dvh61/AudioPowerSupplyV2.0/Power Supply Board v2.0/Power Supply Board v2.0.jpg

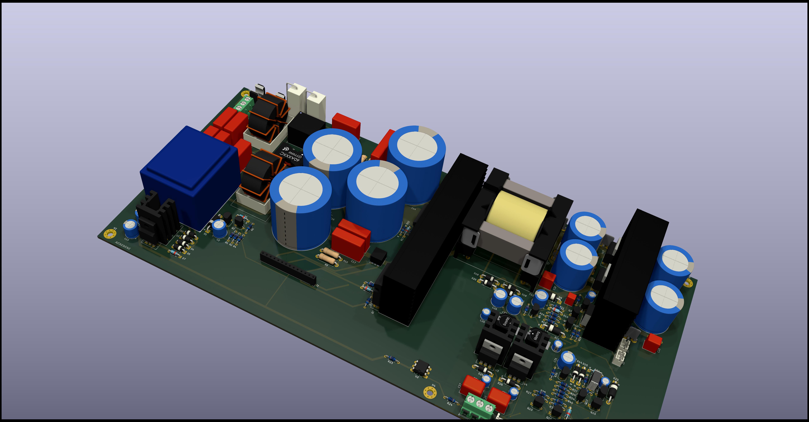
Power Supply Board v2.0/Power Supply Board v2.0.jpg
