dvh61/AudioPowerSupplyV2.0/Power Supply Control Board/Power Supply Control Board/Power Supply Control Board.jpg

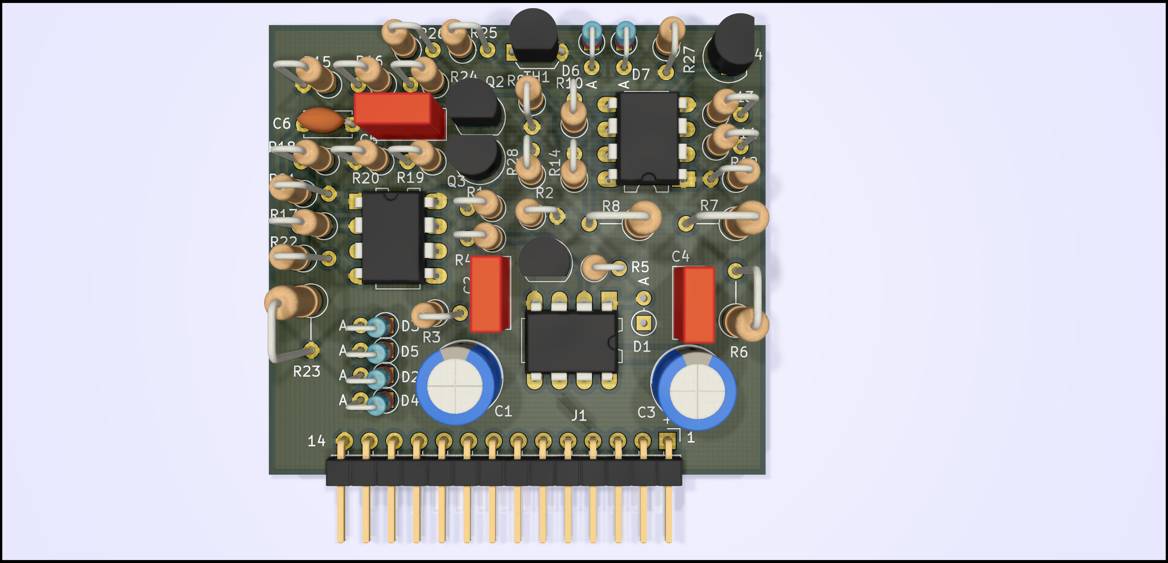
Power Supply Control Board/Power Supply Control Board/Power Supply Control Board.jpg
