dvh61/AudioPowerSupplyV2.0/README.md

# AudioPowerSupplyV2.0
Testing of Kicad/Github capabilities
