dvh61/AudioPowerSupplyV2.0/Power Supply Control Board/Power Supply Control Board/Power Supply Control Board SG3525.jpg

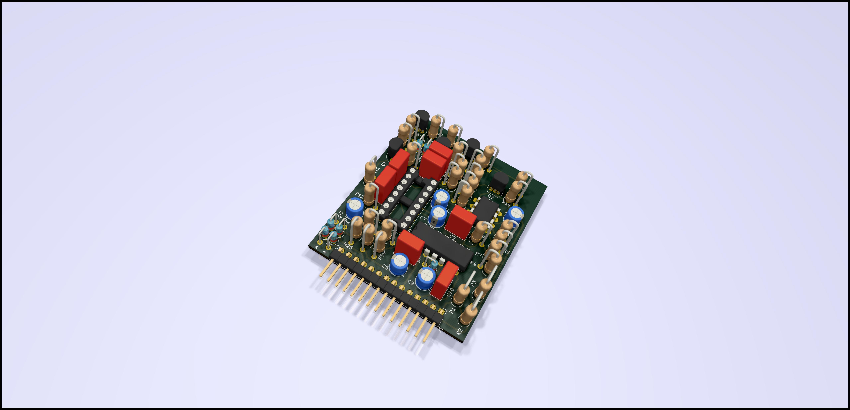
Power Supply Control Board/Power Supply Control Board/Power Supply Control Board SG3525.jpg
