dvh61/AudioPowerSupplyV2.0/Power Supply Control Board/Power Supply Control Board/Gerber/Power Supply Control Board SG3525 BOM.xlsx

Comment | Designator | Footprint | LCSC Part Number
10uF | C1,C4,C5,C7,C8,C13 | 0805 | C15850
100n | C10 | 0805 | C49678
47p | C12 | 0402 | C1567
100uF | C14 | CASE-B_3528 | C16133
0.1uF | C2 | 0805 | C49678
470p | C3 | 0402 | C1537
10n | C6,C9,C11 | 0402 | C15195
US1MG | D1 | SMA | C412437
1N4148 | D2,D3,D4,D5 | SOD-123 | C81598
MMBT5551L | Q1,Q2,Q4 | SOT-23 | C2145
MMBT5401 | Q3 | SOT-23 | C8326
100k | R1,R2,R3 | 1206 | C17900
10k | R11,R18,R19,R20,R21,R22,R27,R28 | 0805 | C17414
22k | R12 | 0805 | C17560
5k6 | R13 | 0805 | C4382
22k | R14 | 0805 | C17560
330 | R15 | 0805 | C17630
470k | R24 | 0805 | C17709
22 | R26 | 1206 | C17958
2k7 | R4 | 0805 | C17530
12k | R17,R23,R25 | 0805 | C17444
47k | R5,R7,R8,R16 | 0805 | C17713
56k | R6 | 0805 | C17756
560 | R9,R10 | 0805 | C28636
LM393 | U1 | SOIC-8_3.9x4.9x1.27P | C7955
SG3525 | U2 | SOIC-16_3.9x9.9x1.27P | C68323
IR2110 | U3 | SOIC-16_7.5x10.3x1.27P | C2968
