dvh61/AudioPowerSupplyV2.0/Power Supply Control Board/Power Supply Control Board/Spice Test Temp KTY.asc

D1: diode; 1N4148
D2: zener; 1N750
Q1: npn; BC546B
Q2: npn; BC546B
R1: res; 18k
R2: res; {Rth}
R3: res; 5k6
R4: res; 12k
R5: res; 33Meg
R6: res; 270k
R7: res; {Rth}
R8: res; 5k6
R10: res; 33Meg
V1: voltage; 16
V2: voltage; 16
Named nets: 0, Out, Out1
.step param T 25 100 1
.meas T
.param factor=table(T,25,1.0,55,0.9,67,1.0,75,1.2,80,1.5,85,2.1,90,3.2,95,9.0,100,30.0)
.meas factor
.param Rth={factor*2200}
;.step param Rth LIST 950 990 1029 1108 1192 1278 1369 1462 1559 1659
.Meas tran res1 FIND V(Out) AT=5m
.op
Thermistor is used PTFM04BD222Q2N34B0.
Data sheet on mouser.de
Circuit for KTY
Circuit for PTFM04BD222Q2N34B0
