dvh61/AudioPowerSupplyV2.0/Auxiliary Power Module/Auxiliary Supply/Auxiliary Supply.kicad_pcb

## KiCad design Auxiliary Power Module/Auxiliary Supply/Auxiliary Supply.kicad_pcb (2021-04-23)

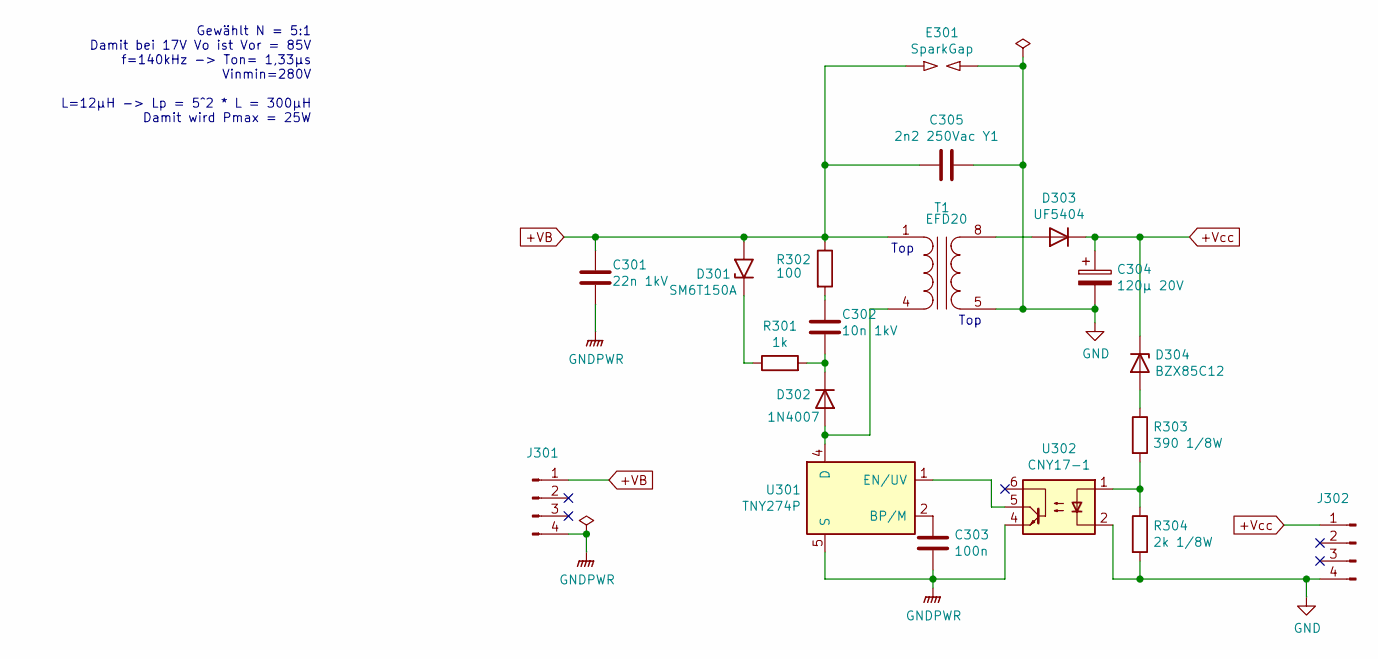
[picture p4: schematic Auxiliary Supply.kicad_sch, Auxiliary Power Supply Board]

Parts:
C301: 22n 1kV; C_Disc_D12.5mm_W5.0mm_P7.50mm
C302: 10n 1kV; C_Disc_D12.5mm_W5.0mm_P7.50mm
C303: 100n; C_Rect_L7.2mm_W2.5mm_P5.00mm_FKS2_FKP2_MKS2_MKP2
C304: 120µ 20V; CP_Radial_D6.3mm_P2.50mm
C305: 2n2 250Vac Y1; C_Rect_L18.0mm_W7.0mm_P15.00mm_FKS3_FKP3
D301: SM6T150A; D_SMB_Handsoldering
D302: 1N4007; D_DO-41_SOD81_P2.54mm_Vertical_KathodeUp
D303: UF5404; D_DO-41_SOD81_P2.54mm_Vertical_KathodeUp
D304: BZX85C12; D_DO-41_SOD81_P3.81mm_Vertical_KathodeUp
E301: SparkGap; SparkGap 5000V Top
J301, J302: Conn_01x04_Male; PinHeader_1x04_P2.54mm_Vertical
R301: 1k; R_Axial_DIN0309_L9.0mm_D3.2mm_P5.08mm_Vertical
R302: 100; R_Axial_DIN0309_L9.0mm_D3.2mm_P12.70mm_Horizontal
R303: 390 1/8W; R_Axial_DIN0207_L6.3mm_D2.5mm_P2.54mm_Vertical
R304: 2k 1/8W; R_Axial_DIN0207_L6.3mm_D2.5mm_P2.54mm_Vertical
T1: B66418W1008D1; Mouser Part Number 871-B66418W1008D1
U301: TNY274P; PowerIntegrations_PDIP-8C
U302: CNY17-1; DIP-6_W7.62mm_LongPads

Connections:
+VB: C301.1, C305.1, D301.2 (A2), E301.1, J301.1, R302.1, T1.1 (AA)
+Vcc: C304.1, D303.1 (K), D304.1 (K), J302.1
GND: C304.2, C305.2, E301.2, J302.4, R304.2, T1.5 (SA), U302.2
GNDPWR: C301.2, C303.2, J301.4, U301.5 (S), U301.6 (S), U301.7 (S), U301.8 (S), U302.4
unnamed: C302.1, R302.2
unnamed: C302.2, D302.1 (K), R301.2
unnamed: C303.1, U301.2 (BP/M)
unnamed: D301.1 (A1), R301.1
unnamed: D302.2 (A), T1.4 (AB), U301.4 (D)
unnamed: D303.2 (A), T1.8 (SB)
unnamed: D304.2 (A), R303.1
unnamed: R303.2, R304.1, U302.1
unnamed: U301.1 (EN/UV), U302.5

Notes on the sheet:
Gewählt N = 5:1 Damit bei 17V Vo ist Vor = 85V f=140kHz -> Ton= 1,33µs Vinmin=280V L=12µH -> Lp = 5^2 * L = 300µH Damit wird Pmax = 25W
Top

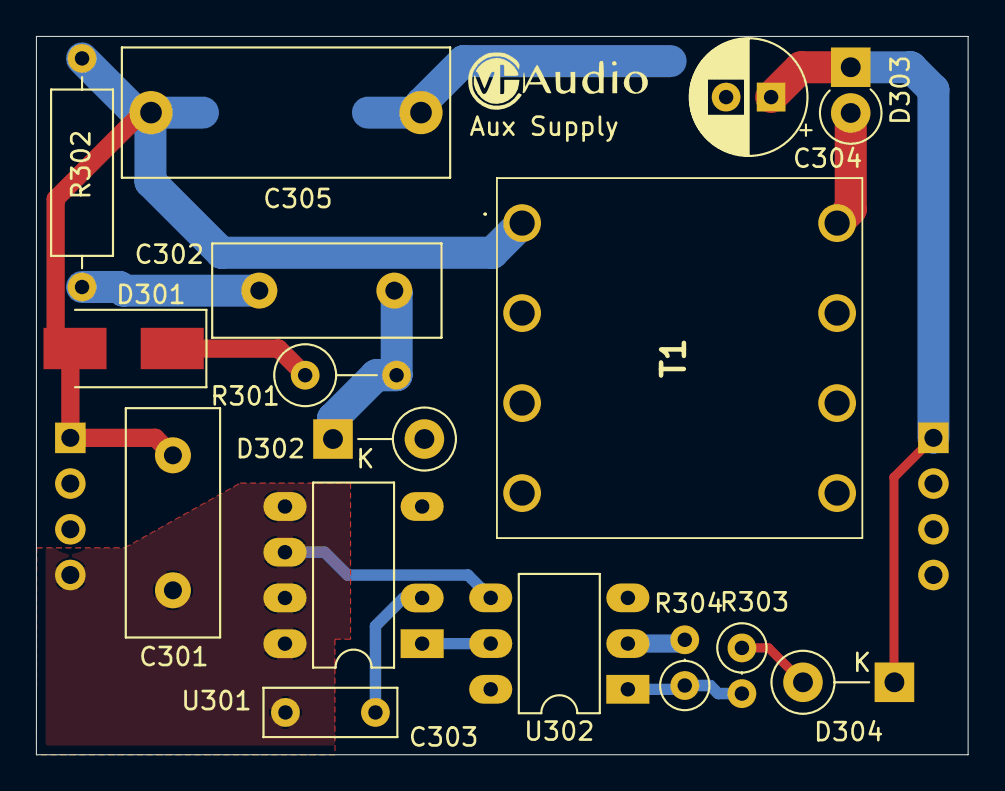
[picture p5: board Auxiliary Supply.kicad_pcb from above]

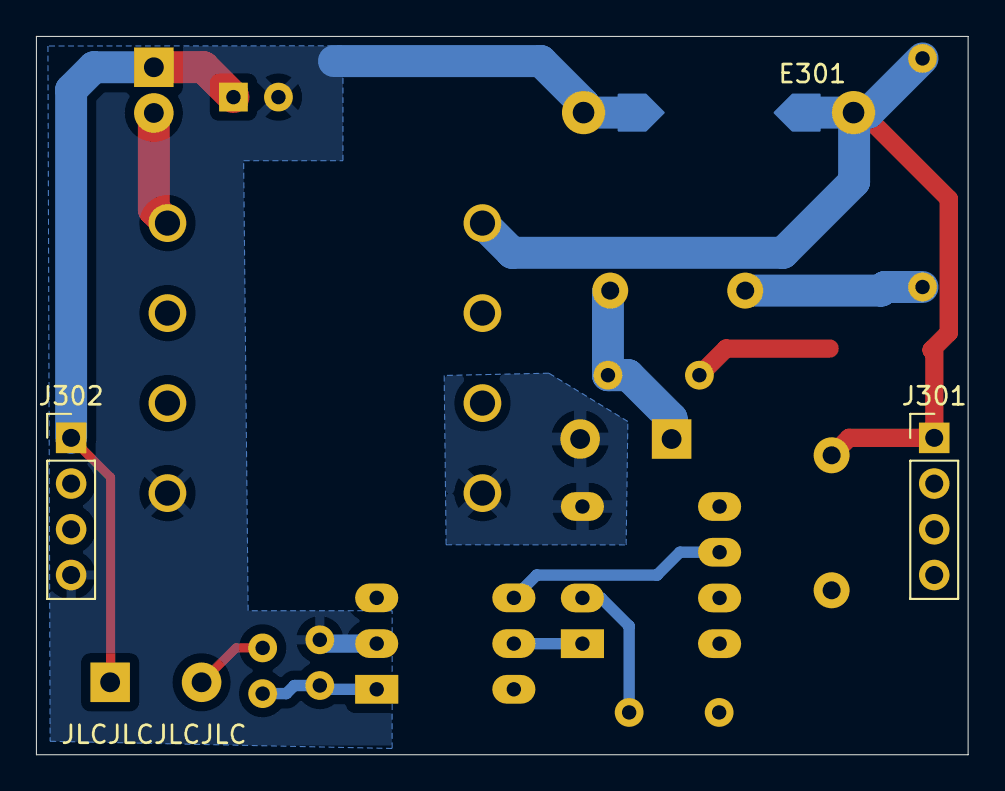
[picture p6: board Auxiliary Supply.kicad_pcb from below]

Board: 2 copper layers, 51.8 x 39.9 mm, 19 parts (3 on the bottom side), 13 nets.
