dvh61/AudioPowerSupplyV2.0/Power Supply Board v2.0/Power Supply Board v2.0.kicad_pcb

## KiCad design Power Supply Board v2.0/Power Supply Board v2.0.kicad_pcb (2021-04-14)

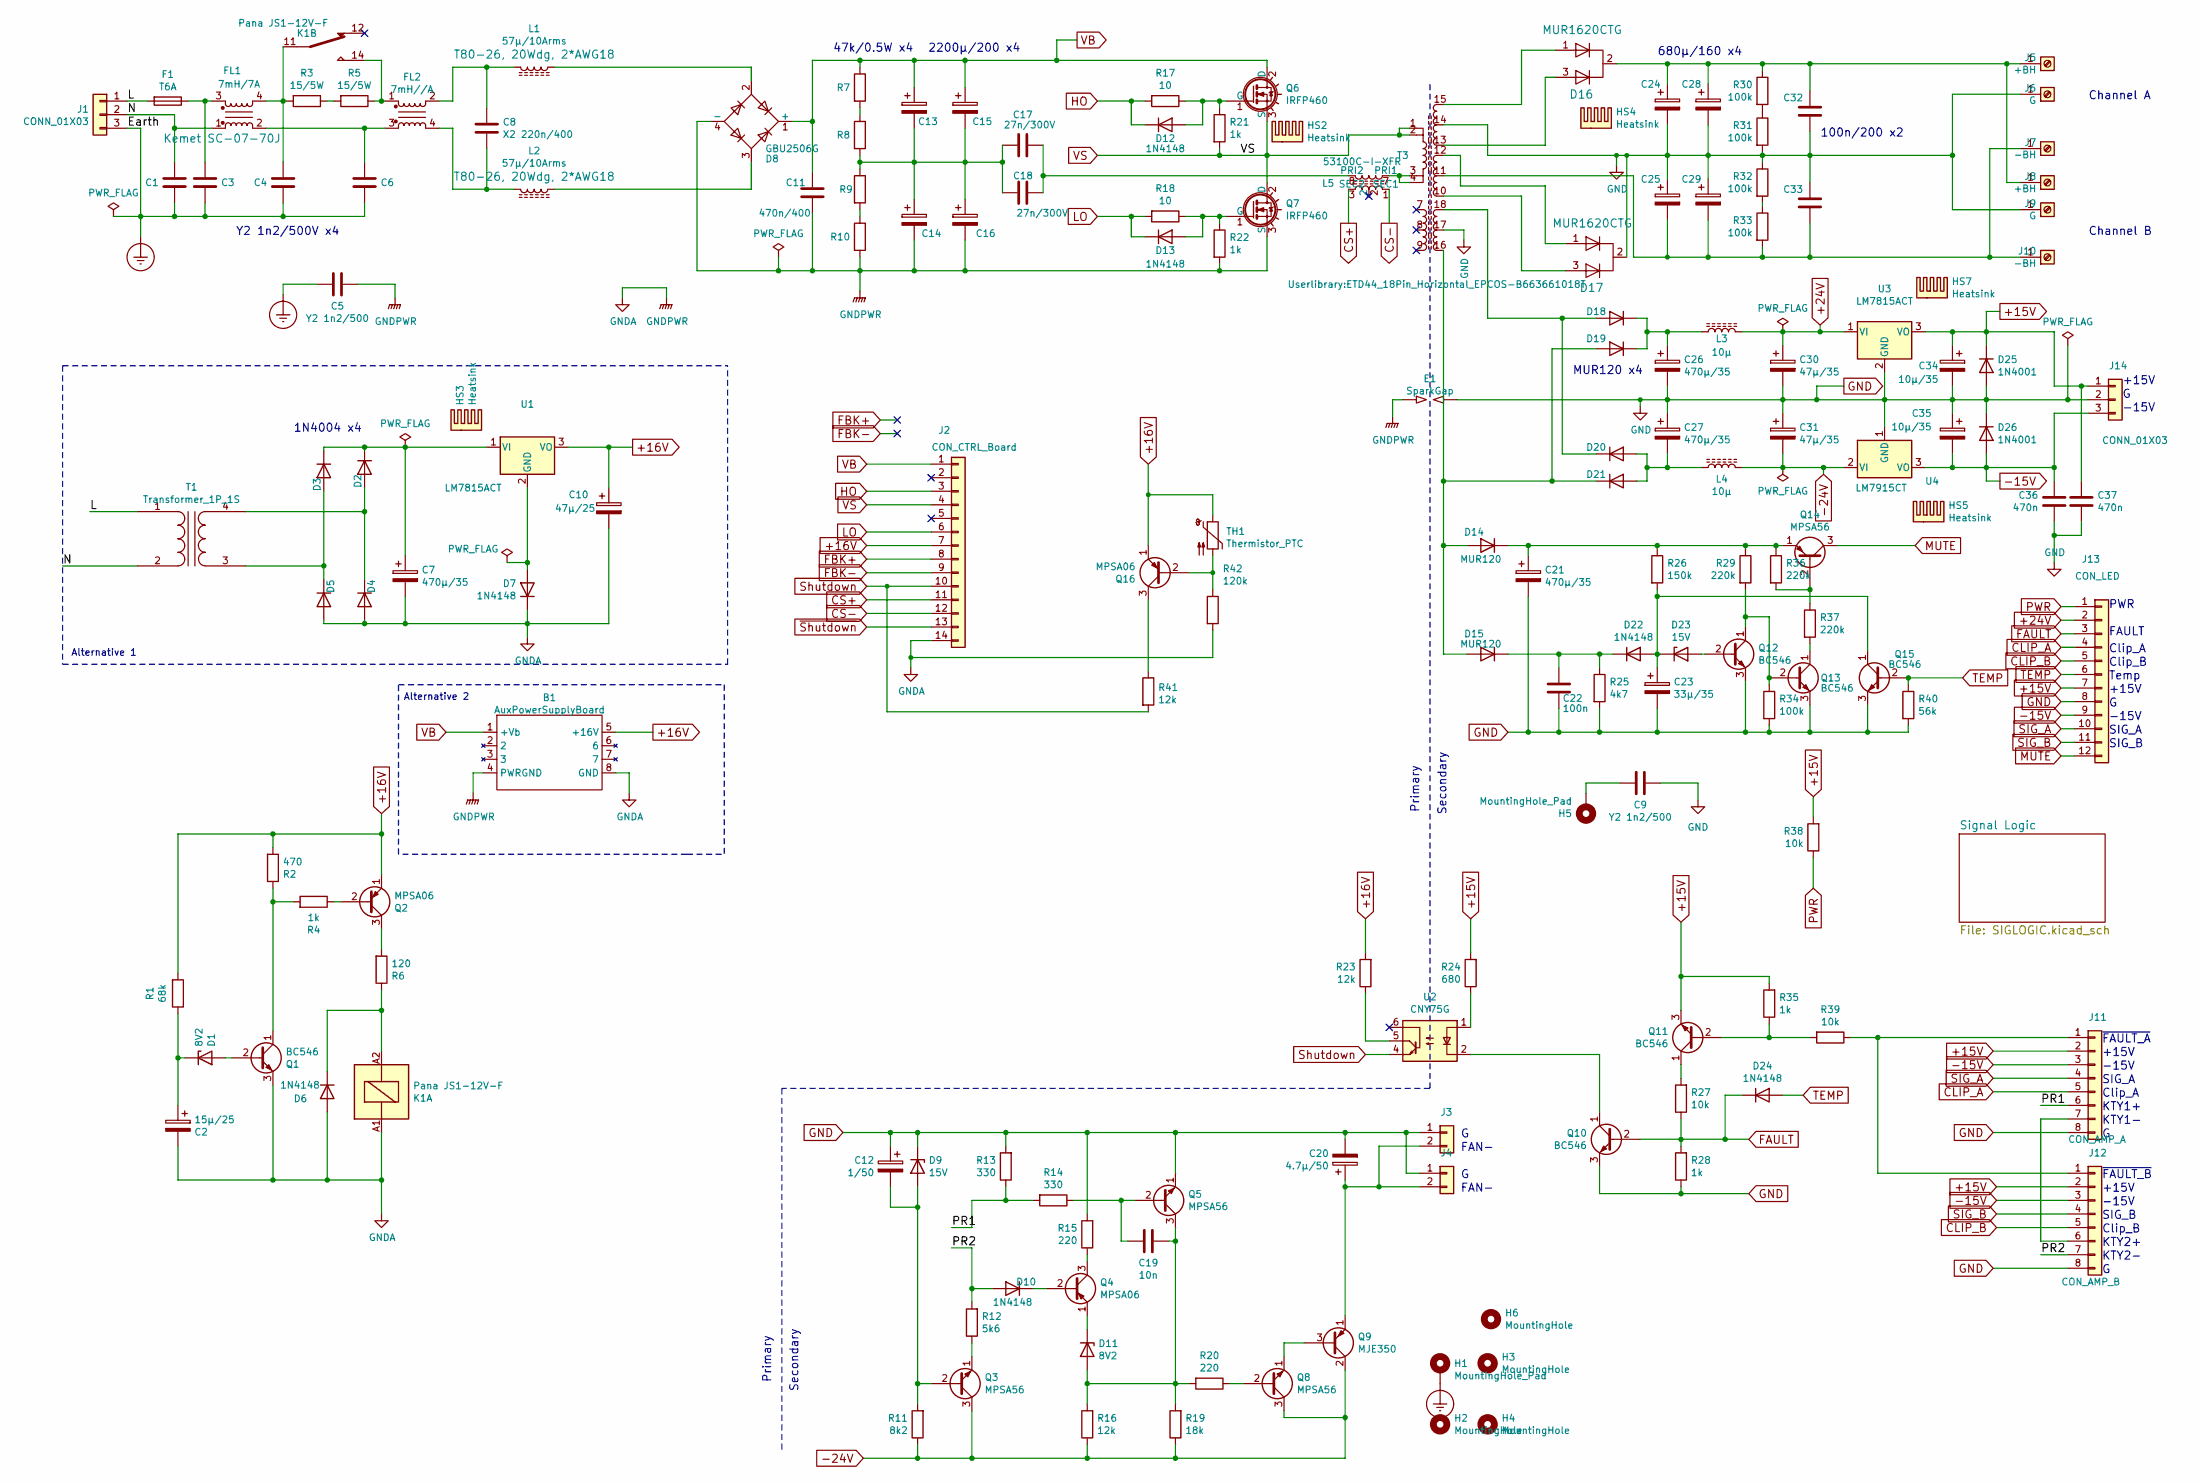
[picture p7: schematic Power Supply Board v2.0.kicad_sch, Power Supply Board]

Parts:
B1: AuxPowerSupplyBoard; Aux Power Supply Board
C1, C3, C4, C5, C6, C9: Y2 1n2/500; C_Rect_L18.0mm_W7.0mm_P15.00mm_FKS3_FKP3
C2: 15µ/25; CP_Radial_D8.0mm_P2.50mm
C7, C21, C26, C27: 470µ/35; CP_Radial_D8.0mm_P3.50mm
C8: X2 220n/400; C_Rect_L18.0mm_W8.0mm_P15.00mm_FKS3_FKP3
C10: 47µ/25; CP_Radial_D8.0mm_P5.00mm
C11: 470n/400; C_Rect_L26.5mm_W6.0mm_P22.50mm_MKS4
C12: 1/50; CP_Radial_D8.0mm_P2.50mm
C13, C14, C15, C16: 2200µ/200V; CP_Radial_D35.0mm_P10.00mm_SnapIn
C17, C18: 27n/300V; C_Rect_L19.0mm_W6.0mm_P15.00mm_MKS4
C19: 10n; C_Rect_L4.6mm_W3.8mm_P2.50mm_MKS02_FKP02
C20: 4.7µ/50; CP_Radial_D5.0mm_P2.00mm
C22: 100n; C_Rect_L9.0mm_W4.0mm_P7.50mm_MKT
C23: 33µ/35; CP_Radial_D5.0mm_P2.00mm
C24, C25, C28, C29: 680µ/200V; CP_Radial_D25.0mm_P10.00mm_SnapIn
C30, C31: 47µ/35; CP_Radial_D5.0mm_P2.50mm
C32, C33: 100n/100; C_Rect_L7.2mm_W5.5mm_P5.00mm_FKS2_FKP2_MKS2_MKP2
C34, C35: 10µ/35; CP_Radial_D5.0mm_P2.50mm
C36, C37: 470n; C_Rect_L7.2mm_W11.0mm_P5.00mm_FKS2_FKP2_MKS2_MKP2
D1, D11: 8V2; D_DO-15_P12.70mm_Horizontal
D2, D3, D4, D5: 1N4004; D_DO-41_SOD81_P7.62mm_Horizontal
D6, D7, D10, D12, D13, D22, D24: 1N4148; D_DO-35_SOD27_P7.62mm_Horizontal
D8: GBU2506G; Diode_Bridge_Vishay_GBU
D9, D23: 15V; D_DO-15_P12.70mm_Horizontal
D14, D15, D18, D19, D20, D21: MUR120; D_DO-41_SOD81_P10.16mm_Horizontal
D16, D17: MUR1620CTG; TO-220-3_Vertical
D25, D26: 1N4001; D_DO-41_SOD81_P10.16mm_Horizontal
E1: SparkGap; SparkGap 5000V Top
F1: T6A; Fuseholder_Cylinder-5x20mm_Schurter_0031_8201_Horizontal_Op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
FL1: 7mH/7A; L_CommonMode_Toroid_Vertical_L35mm_W25mm_Px19mm_Py18mm_Keme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
FL2: 7mH//A; L_CommonMode_Toroid_Vertical_L35mm_W25mm_Px19mm_Py18mm_Keme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
H1, H5: MountingHole_Pad; MountingHole_3.5mm_Pad_Via
H2, H3, H4, H6: MountingHole; MountingHole_3.5mm_Pad_Via
HS2: Heatsink; Heatsink_100x45x18mm_3xFixationM3
HS3, HS5, HS7: Heatsink; Heatsink EA2 T220
HS4: Heatsink; Heatsink_70x45x18mm_2xFixationM3
J1: CONN_01X03; TerminalBlock_Phoenix_PT-1,5-3-5.0-H_1x03_P5.00mm_Horizontal
J2: CON_CTRL_Board; PinSocket_1x14_P2.54mm_Vertical
J3, J4: CONN_01X02; JST_PH_B2B-PH-K_1x02_P2.00mm_Vertical
J5, J8: +BH; PCB_Connector_6.35x0.81mm_Vertical
J6, J9: G; PCB_Connector_6.35x0.81mm_Vertical
J7, J10: -BH; PCB_Connector_6.35x0.81mm_Vertical
J11: CON_AMP_A; JST_EH_B8B-EH-A_1x08_P2.50mm_Vertical
J12: CON_AMP_B; JST_EH_B8B-EH-A_1x08_P2.50mm_Vertical
J13: CON_LED; JST_EH_B12B-EH-A_1x12_P2.50mm_Vertical
J14: CONN_01X03; JST_EH_B3B-EH-A_1x03_P2.50mm_Vertical
K1: Pana JS1-12V-F; FINDER_36.11
L1, L2: 57µ/10Arms; L_muRata_6000A
L3, L4: 10µ; L_Wuerth_WE-PD-Typ-LS_Handsoldering
L5: 53100C-I-XFR; 53100C
Q1, Q10, Q11, Q12, Q13, Q15: BC546; TO-92_Wide
Q2, Q4, Q16: MPSA06; TO-92_Wide
Q3, Q5, Q8: MPSA56; TO-92_Wide
Q6, Q7: IRFP460; TO-247-3_Vertical
Q9: MJE350; TO-126-3_Vertical
Q14: MPSA56; TO-92_Inline
R1: 68k; R_Axial_DIN0204_L3.6mm_D1.6mm_P7.62mm_Horizontal
R2: 470; R_Axial_DIN0204_L3.6mm_D1.6mm_P7.62mm_Horizontal
R3, R5: 15/5W; R_Axial_Power_L25.0mm_W9.0mm_P7.62mm_Vertical
R4, R21, R22, R28, R35: 1k; R_Axial_DIN0204_L3.6mm_D1.6mm_P7.62mm_Horizontal
R6: 120; R_Axial_DIN0204_L3.6mm_D1.6mm_P7.62mm_Horizontal
R7, R8, R9, R10: 47k/0.5W; R_Axial_DIN0411_L9.9mm_D3.6mm_P12.70mm_Horizontal
R11: 8k2; R_Axial_DIN0204_L3.6mm_D1.6mm_P7.62mm_Horizontal
R12: 5k6; R_Axial_DIN0204_L3.6mm_D1.6mm_P7.62mm_Horizontal
R13, R14: 330; R_Axial_DIN0204_L3.6mm_D1.6mm_P7.62mm_Horizontal
R15, R20: 220; R_Axial_DIN0204_L3.6mm_D1.6mm_P7.62mm_Horizontal
R16, R23, R41: 12k; R_Axial_DIN0204_L3.6mm_D1.6mm_P7.62mm_Horizontal
R17, R18: 10; R_Axial_DIN0204_L3.6mm_D1.6mm_P7.62mm_Horizontal
R19: 18k; R_Axial_DIN0204_L3.6mm_D1.6mm_P7.62mm_Horizontal
R24: 680; R_Axial_DIN0204_L3.6mm_D1.6mm_P7.62mm_Horizontal
R25: 4k7; R_Axial_DIN0204_L3.6mm_D1.6mm_P7.62mm_Horizontal
R26: 150k; R_Axial_DIN0204_L3.6mm_D1.6mm_P7.62mm_Horizontal
R27, R38, R39: 10k; R_Axial_DIN0204_L3.6mm_D1.6mm_P7.62mm_Horizontal
R29, R36, R37: 220k; R_Axial_DIN0204_L3.6mm_D1.6mm_P7.62mm_Horizontal
R30, R31, R32, R33, R34: 100k; R_Axial_DIN0204_L3.6mm_D1.6mm_P7.62mm_Horizontal
R40: 56k; R_Axial_DIN0204_L3.6mm_D1.6mm_P7.62mm_Horizontal
R42: 120k; R_Axial_DIN0204_L3.6mm_D1.6mm_P7.62mm_Horizontal
T1: Transformer_1P_1S; Transformer_Block_EI42_VC-05VA_1xSec
T3: Half_Bridge_Transformer; ETD44_18Pin_Horizontal_EPCOS-B663661018T
TH1: Thermistor_PTC; PTC Epcos D1052
U1: LM7815ACT; TO-220F-3_Vertical
U2: CNY75G; DIP-6_W7.62mm_LongPads
U3: LM7815ACT; TO-220-3_Vertical
U4: LM7915CT; TO-220-3_Vertical

Connections:
+15V: C34.1, C37.1, D25.1 (K), J11.2, J12.2, J13.7, J14.1, Q11.3 (E), R24.2, R35.2, R38.2, U3.3 (VO)
+16V: B1.5 (+16V), C10.1, J2.7, Q2.1 (E), Q16.1 (E), R1.2, R2.2, R23.2, TH1.1, U1.3 (VO)
+24V: C30.1, J13.2, L3.1, U3.1 (VI)
-15V: C35.2, C36.1, D26.2 (A), J11.3, J12.3, J13.9, J14.3, U4.3 (VO)
-24V: C31.2, L4.1, Q3.3 (C), Q8.3 (C), Q9.2 (C), R11.1, R16.1, R19.1, U4.2 (VI)
/L: F1.2, J1.1, T1.1 (AA)
/N: C1.1, FL1.1, J1.2, T1.2 (AB)
/PR1: J11.6, R13.1, R14.2
/PR2: D10.2 (A), J12.7, R12.2
CLIP_A: J11.5, J13.4
CLIP_B: J12.5, J13.5
CS+: J2.11, L5.3 (SEC2)
CS-: J2.12, L5.1 (SEC1)
Earth_Protective: C1.2, C3.2, C4.2, C5.2, C6.2, H1.1, J1.3
FAULT: D24.1 (K), J13.3, Q10.2 (B), R27.1, R28.2
FBK+: J2.8
FBK-: J2.9
GND: C9.1, C12.1, C20.2, C21.2, C22.2, C23.2, C24.2, C25.1, C26.2, C27.1, C28.2, C29.1, C30.2, C31.1, C32.2, C33.1, C34.2, C35.1, C36.2, C37.2, D9.1 (K), D17.2 (common), D25.2 (A), D26.1 (K), E1.2, J3.1, J4.1, J6.1, J9.1, J11.8, J12.8, J13.8, J14.2, Q5.1 (E), Q10.3 (E), Q12.3 (E), Q13.3 (E), Q15.3 (E), R13.2, R15.2, R25.2, R28.1, R31.2, R32.1, R34.2, R40.2, T3.14, T3.17, U3.2 (GND), U4.1 (GND)
GNDA: B1.4 (PWRGND), B1.8 (GND), C2.2, C5.1, C7.2, C10.2, C11.1, C14.2, C16.2, D4.2 (A), D5.2 (A), D6.2 (A), D7.1 (K), D8.4 (-), E1.1, J2.14, K1.A1, Q1.3 (E), Q7.3 (S), R10.2, R22.2, R42.2
HO: D12.1 (K), J2.3, R17.2
LO: D13.1 (K), J2.6, R18.2
MUTE: J13.12, Q14.3 (C)
unnamed: C2.1, D1.1 (K), R1.1
unnamed: C3.1, F1.1, FL1.3
unnamed: C4.1, FL1.4, K1.11, R3.2
unnamed: C6.1, FL1.2, FL2.3
unnamed: C7.1, D2.1 (K), D3.1 (K), U1.1 (VI)
unnamed: C8.1, FL2.2, L1.2
unnamed: C8.2, FL2.4, L2.2
unnamed: C9.2, H5.1
unnamed: C12.2, D9.2 (A), Q3.2 (B), R11.2
unnamed: C13.2, C14.1, C15.2, C16.1, C17.2, C18.1, R8.2, R9.1
unnamed: C17.1, C18.2, L5.8 (PRI2)
unnamed: C19.1, Q5.2 (B), R14.1
unnamed: C19.2, D11.2 (A), Q5.3 (C), R16.2, R19.2, R20.2
unnamed: C20.1, J3.2, J4.2, Q9.1 (E)
unnamed: C21.1, D14.1 (K), Q14.1 (E), R26.1, R29.1, R36.1
unnamed: C22.1, D15.1 (K), D22.1 (K), R25.1
unnamed: C23.1, D22.2 (A), D23.1 (K), Q15.1 (C), R26.2
unnamed: C24.1, C28.1, C32.1, D16.2 (common), J5.1, J8.1, R30.1
unnamed: C25.2, C29.2, C33.2, J7.1, J10.1, R33.2, T3.11
unnamed: C26.1, D18.1 (K), D19.1 (K), L3.2
unnamed: C27.2, D20.2 (A), D21.2 (A), L4.2
unnamed: D1.2 (A), Q1.2 (B)
unnamed: D2.2 (A), D4.1 (K), T1.4 (SB)
unnamed: D3.2 (A), D5.1 (K), T1.3 (SA)
unnamed: D6.1 (K), K1.A2, R6.1
unnamed: D7.2 (A), U1.2 (GND)
unnamed: D8.2 (~~), L1.1
unnamed: D8.3 (~~), L2.1
unnamed: D10.1 (K), Q4.2 (B)
unnamed: D11.1 (K), Q4.1 (E)
unnamed: D12.2 (A), Q6.1 (G), R17.1, R21.1
unnamed: D13.2 (A), Q7.1 (G), R18.1, R22.1
unnamed: D14.2 (A), D15.2 (A), D19.2 (A), D21.1 (K), T3.16
unnamed: D16.1 (A1), T3.15
unnamed: D16.3 (A2), T3.13
unnamed: D18.2 (A), D20.1 (K), T3.18
unnamed: D23.2 (A), Q12.2 (B)
unnamed: FL2.1, K1.14, R5.1
unnamed: J11.1, J12.1, R39.1
unnamed: J11.7, J12.6
unnamed: L5.7 (PRI1), T3.3, T3.4
unnamed: Q1.1 (C), R2.1, R4.2
unnamed: Q2.2 (B), R4.1
unnamed: Q2.3 (C), R6.2
unnamed: Q3.1 (E), R12.1
unnamed: Q4.3 (C), R15.1
unnamed: Q8.1 (E), Q9.3 (B)
unnamed: Q8.2 (B), R20.1
unnamed: Q10.1 (C), U2.2
unnamed: Q11.1 (C), R27.2
unnamed: Q11.2 (B), R35.1, R39.2
unnamed: Q12.1 (C), Q13.2 (B), R29.2, R34.1
unnamed: Q13.1 (C), R37.2
unnamed: Q14.2 (B), R36.2, R37.1
unnamed: Q16.2 (B), R42.1, TH1.2
unnamed: Q16.3 (C), R41.1
unnamed: R3.1, R5.2
unnamed: R7.2, R8.1
unnamed: R9.2, R10.1
unnamed: R23.1, U2.5
unnamed: R24.1, U2.1
unnamed: R30.2, R31.1
unnamed: R32.2, R33.1
unnamed: D17.3 (A2), T3.10
unnamed: D17.1 (A1), T3.12
PWR: J13.1, R38.1
SIG_A: J11.4, J13.10
SIG_B: J12.4, J13.11
Shutdown: J2.10, R41.2, U2.4
TEMP: D24.2 (A), J13.6, Q15.2 (B), R40.1
VB: B1.1 (+Vb), C11.2, C13.1, C15.1, D8.1 (+), J2.1, Q6.2 (D), R7.1
VS: J2.4, Q6.3 (S), Q7.2 (D), R21.2, T3.1, T3.2
~Shutdown: J2.13

Notes on the sheet:
Alternative 1
Y2 1n2/500V x4
1N4004 x4
Alternative 2
Primary
Secondary
47k/0.5W x4
2200µ/200 x4
FAN-
MUR120 x4
680µ/160 x4
100n/200 x2
Channel A
Channel B
~FAULT_A
+15V
-15V
SIG_A
Clip_A
KTY1+
KTY1-
~FAULT_B
SIG_B
Clip_B
KTY2+
KTY2-
PWR
FAULT
Temp
SIG_B

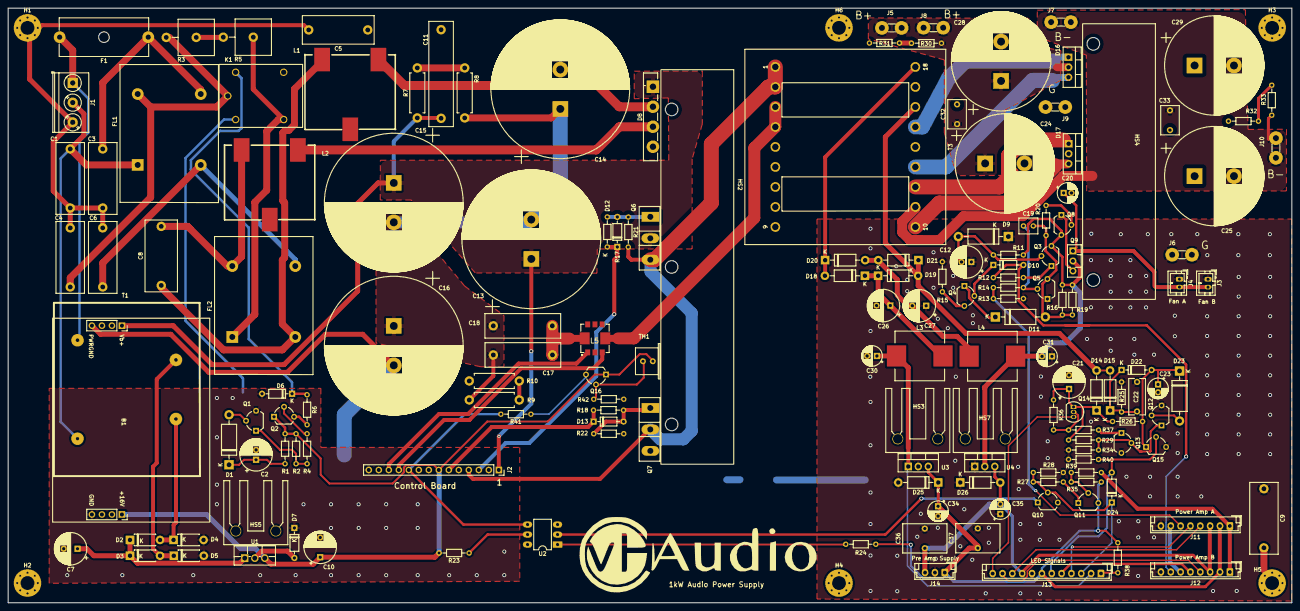
[picture p8: board Power Supply Board v2.0.kicad_pcb from above]

Board: 2 copper layers, 326.0 x 151.0 mm, 164 parts (1 on the bottom side), 92 nets.
