dvh61/AudioPowerSupplyV2.0/Power Supply Control Board/Power Supply Control Board/Power Supply Control Board.kicad_pcb

## KiCad design Power Supply Control Board/Power Supply Control Board/Power Supply Control Board.kicad_pcb (2021-04-09)

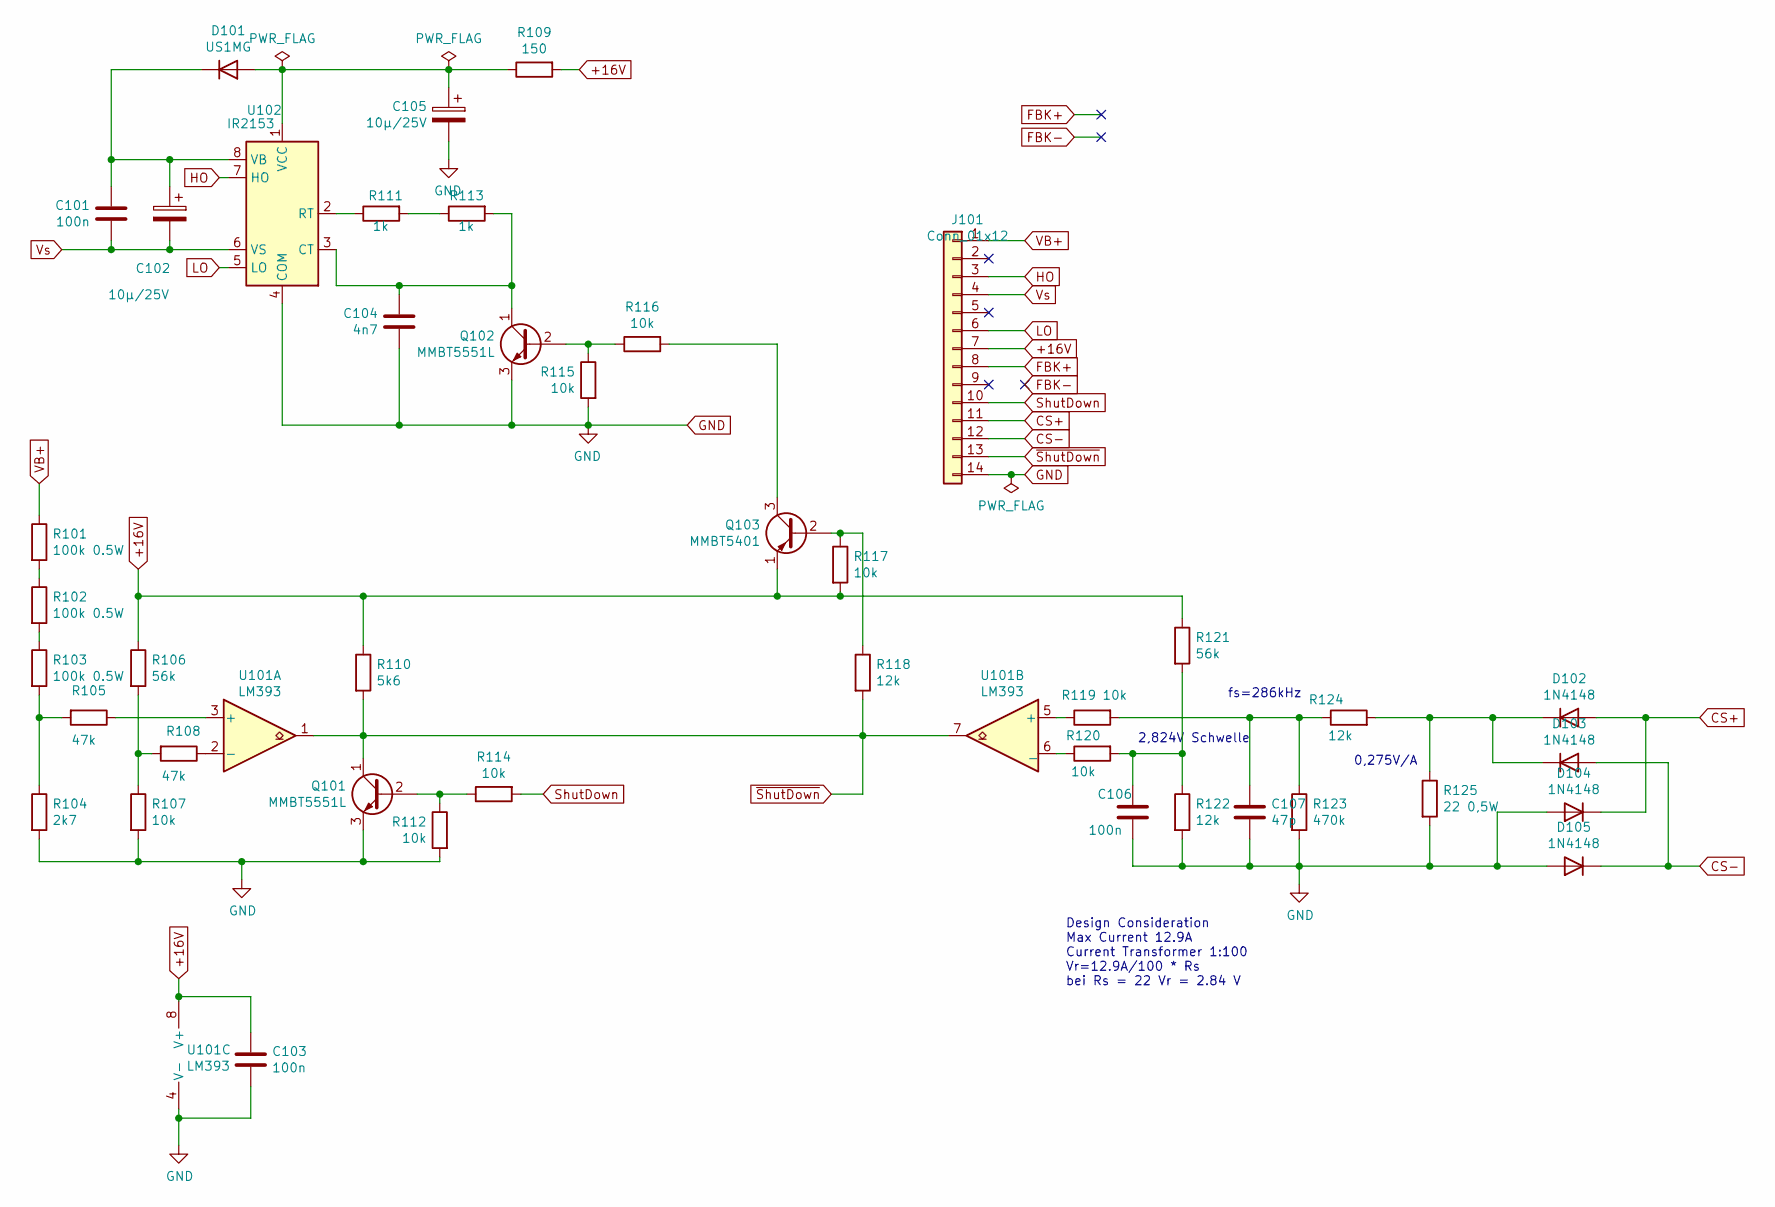
[picture p9: schematic Power Supply Control Board.kicad_sch, Power Supply Control Board IR2153]

Parts:
C101, C103, C106: 100n; C_0805_2012Metric
C102, C105: 10µ/25V; C_0805_2012Metric
C104: 4n7; C_0805_2012Metric
C107: 47p; C_0402_1005Metric
D101: US1MG; D_SMA
D102, D103, D104, D105: 1N4148; D_SOD-123
J101: Conn_01x12; PinHeader_1x14_P2.54mm_Horizontal
Q101, Q102: MMBT5551L; SOT-23
Q103: MMBT5401; SOT-23
R101, R102, R103: 100k 0.5W; R_1206_3216Metric
R104: 2k7; R_0805_2012Metric
R105, R108: 47k; R_0805_2012Metric
R106, R121: 56k; R_0805_2012Metric
R107, R112, R114, R115, R116, R117, R119, R120: 10k; R_0805_2012Metric
R109: 150; R_0805_2012Metric
R110: 5k6; R_0805_2012Metric
R111, R113: 1k; R_0805_2012Metric
R118, R122, R124: 12k; R_0805_2012Metric
R123: 470k; R_0805_2012Metric
R125: 22 0,5W; R_1206_3216Metric
U101: LM393; SOIC-8_3.9x4.9mm_P1.27mm
U102: IR2153; SOIC-8_3.9x4.9mm_P1.27mm; LCSC C79666

Connections:
+16V: C103.1, J101.7, Q103.1 (E), R106.1, R109.2, R110.1, R117.2, R121.1, U101.8 (V+)
CS+: D102.2 (A), D104.1 (K), J101.11
CS-: D103.2 (A), D105.1 (K), J101.12
FBK+: J101.8
GND: C103.2, C104.2, C105.2, C106.2, C107.2, D104.2 (A), D105.2 (A), J101.14, Q101.3 (E), Q102.3 (E), R104.2, R107.2, R112.2, R115.2, R122.2, R123.2, R125.2, U101.4 (V-), U102.4 (COM)
HO: J101.3, U102.7 (HO)
LO: J101.6, U102.5 (LO)
unnamed: C101.1, C102.1, D101.1 (K), U102.8 (VB)
unnamed: C104.1, Q102.1 (C), R113.2, U102.3 (CT)
unnamed: C106.1, R120.2, R121.2, R122.1
unnamed: C107.1, R119.2, R123.1, R124.1
unnamed: C105.1, D101.2 (A), R109.1, U102.1 (VCC)
unnamed: D102.1 (K), D103.1 (K), R124.2, R125.1
unnamed: Q101.2 (B), R112.1, R114.1
unnamed: Q102.2 (B), R115.1, R116.1
unnamed: Q103.2 (B), R117.1, R118.1
unnamed: Q103.3 (C), R116.2
unnamed: R101.2, R102.1
unnamed: R102.2, R103.1
unnamed: R103.2, R104.1, R105.2
unnamed: R105.1, U101.3 (+)
unnamed: R106.2, R107.1, R108.2
unnamed: R108.1, U101.2 (-)
unnamed: R111.1, U102.2 (RT)
unnamed: R111.2, R113.1
unnamed: R119.1, U101.5 (+)
unnamed: R120.1, U101.6 (_)
ShutDown: J101.10, R114.2
VB+: J101.1, R101.1
Vs: C101.2, C102.2, J101.4, U102.6 (VS)
~ShutDown: J101.13, Q101.1 (C), R110.2, R118.2, U101.1, U101.7

Notes on the sheet:
Design Consideration Max Current 12.9A Current Transformer 1:100 Vr=12.9A/100 * Rs bei Rs = 22 Vr = 2.84 V
2,824V Schwelle
fs=286kHz
0,275V/A

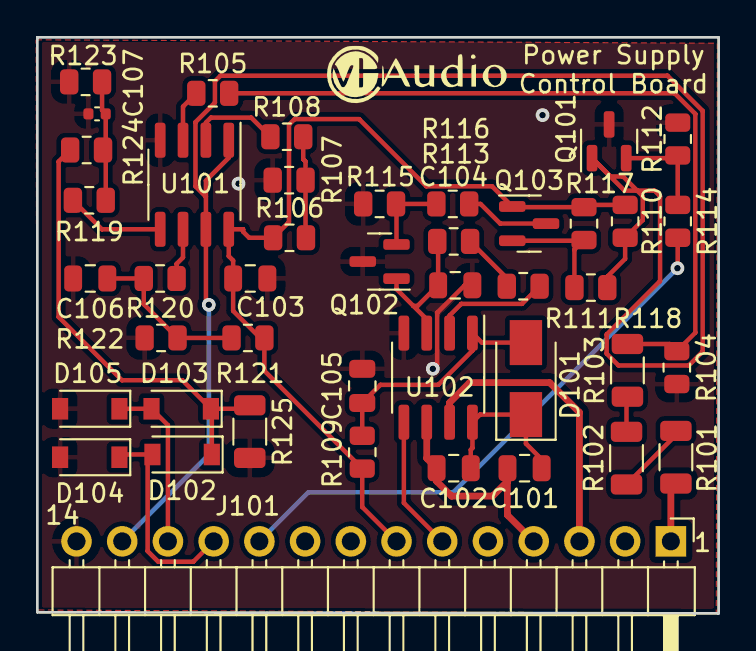
[picture p10: board Power Supply Control Board.kicad_pcb from above]

Board: 2 copper layers, 37.8 x 32.0 mm, 43 parts (0 on the bottom side), 30 nets.
