dvh61/AudioPowerSupplyV2.0/Power Supply Control Board/Power Supply Control Board/Power Supply Control Board SG3525.kicad_pcb

## KiCad design Power Supply Control Board/Power Supply Control Board/Power Supply Control Board SG3525.kicad_pcb (2021-04-09)

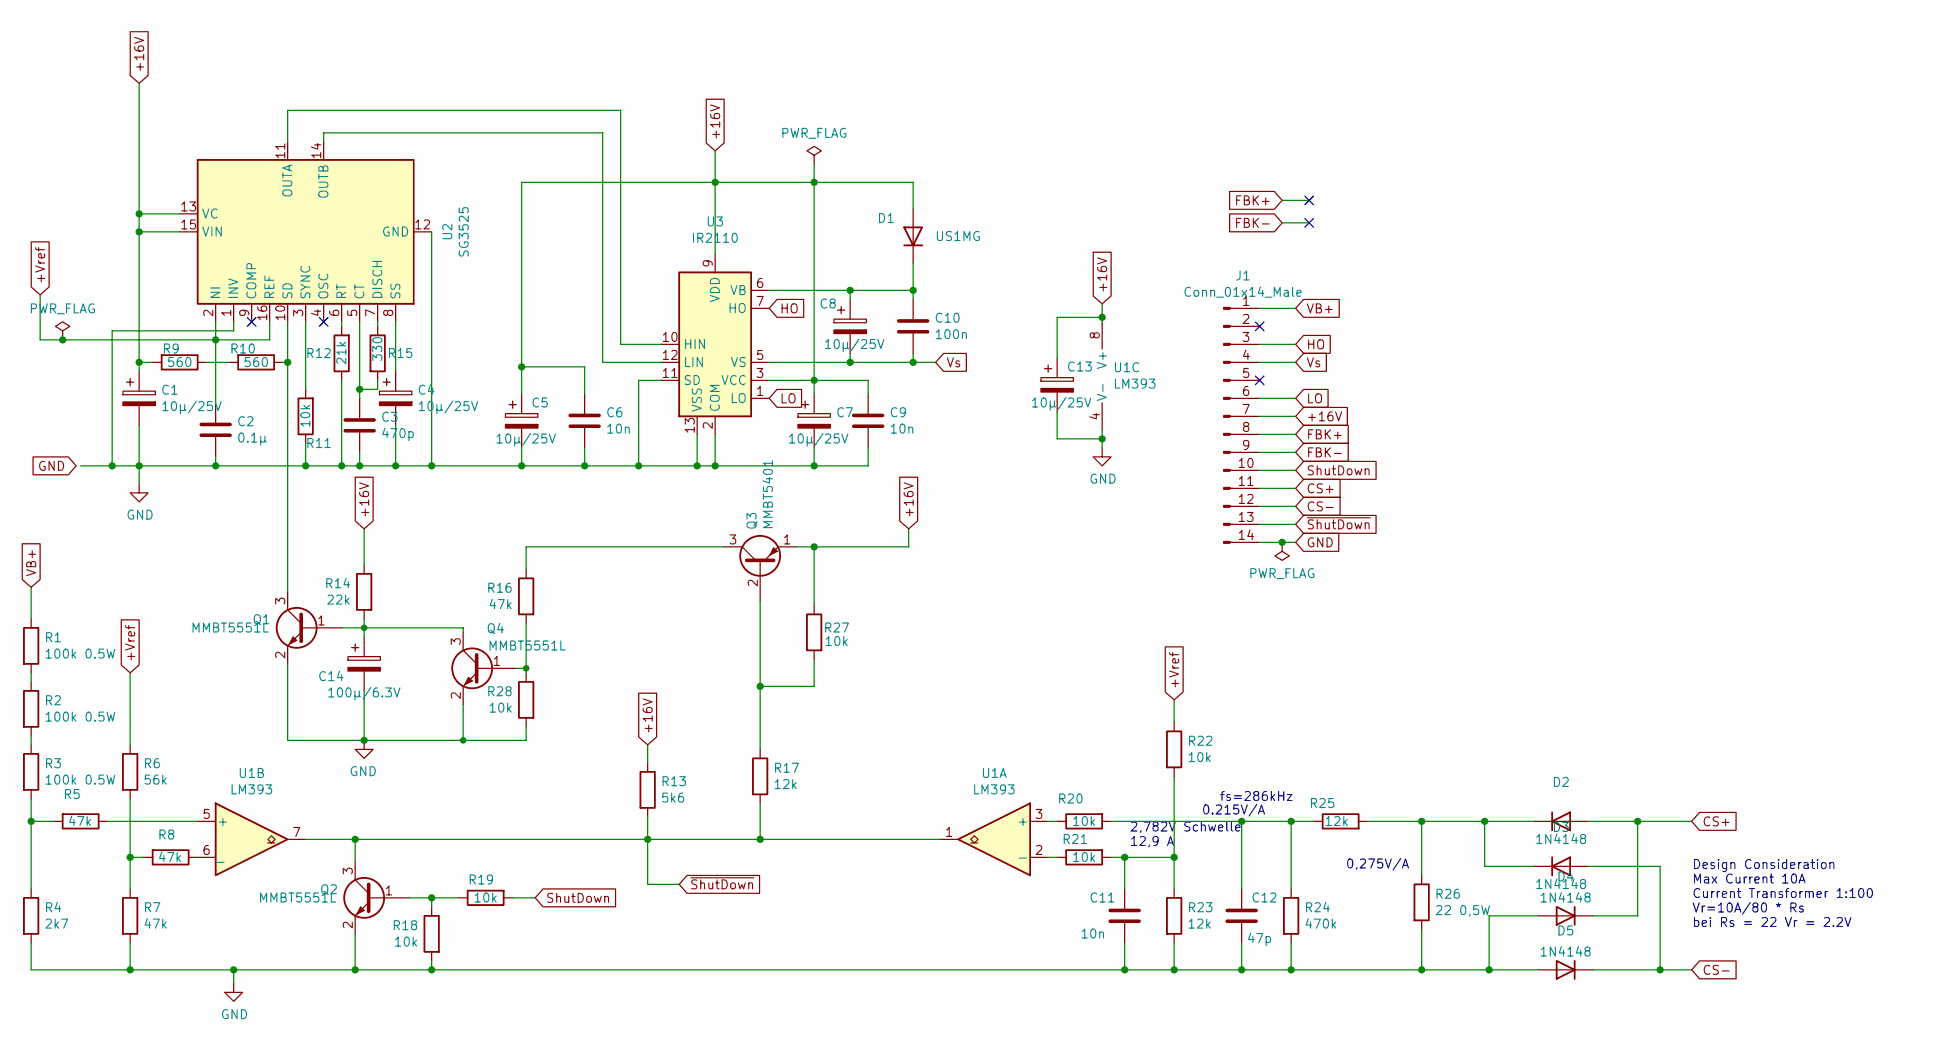
[picture p11: schematic Power Supply Control Board SG3525.kicad_sch]

Parts:
C1, C4, C5, C7, C8, C13: 10µ/25V; C_0805_2012Metric; LCSC C15850
C2: 0.1µ; C_0805_2012Metric; LCSC C49678
C3: 470p; C_0402_1005Metric; LCSC C1537
C6: 10n; C_0402_1005Metric; LCSC C15195
C9, C11: 10n; C_0402_1005Metric
C10: 100n; C_0805_2012Metric; LCSC C49678
C12: 47p; C_0402_1005Metric; LCSC C1567
C14: 100µ/6.3V; CP_EIA-3528-21_Kemet-B; LCSC C134723
D1: US1MG; D_SMA; LCSC C412437
D2, D3, D4, D5: 1N4148; D_SOD-123; LCSC C81598
J1: Conn_01x14_Male; PinHeader_1x14_P2.54mm_Horizontal
Q1, Q2, Q4: MMBT5551L; SOT-23
Q3: MMBT5401; SOT-23
R1, R2, R3: 100k 0.5W; R_1206_3216Metric
R4: 2k7; R_0805_2012Metric
R5, R7, R8, R16: 47k; R_0805_2012Metric
R6: 56k; R_0805_2012Metric
R9, R10: 560; R_0805_2012Metric
R11, R18, R19, R20, R21, R22, R27, R28: 10k; R_0805_2012Metric
R12: 21k; R_0805_2012Metric
R13: 5k6; R_0805_2012Metric
R14: 22k; R_0805_2012Metric
R15: 330; R_0805_2012Metric
R17, R23, R25: 12k; R_0805_2012Metric
R24: 470k; R_0805_2012Metric
R26: 22 0,5W; R_1206_3216Metric
U1: LM393; SOIC-8_3.9x4.9mm_P1.27mm
U2: SG3525; SO-16_3.9x9.9mm_P1.27mm; LCSC C68323
U3: IR2110; SOIC-16W_7.5x10.3mm_P1.27mm; LCSC C2968

Connections:
+16V: C1.1, C5.1, C6.1, C7.1, C9.1, C13.1, D1.2 (A), J1.7, Q3.1 (E), R9.2, R13.1, R14.1, R27.1, U1.8 (V+), U2.13 (VC), U2.15 (VIN), U3.3 (VCC), U3.9 (VDD)
+Vref: C2.1, R6.1, R22.1, U2.2 (NI), U2.16 (REF)
CS+: D2.2 (A), D4.1 (K), J1.11
CS-: D3.2 (A), D5.1 (K), J1.12
FBK+: J1.8
FBK-: J1.9
GND: C1.2, C2.2, C3.2, C4.2, C5.2, C6.2, C7.2, C9.2, C11.2, C12.2, C13.2, C14.2, D4.2 (A), D5.2 (A), J1.14, Q1.2 (E), Q2.2 (E), Q4.2 (E), R4.2, R7.2, R11.1, R12.1, R18.2, R23.2, R24.2, R26.2, R28.2, U1.4 (V-), U2.1 (INV), U2.12 (GND), U3.2 (COM), U3.11 (SD), U3.13 (VSS)
HO: J1.3, U3.7 (HO)
LO: J1.6, U3.1 (LO)
unnamed: C3.1, R15.2, U2.5 (CT)
unnamed: C4.1, U2.8 (SS)
unnamed: C8.1, C10.1, D1.1 (K), U3.6 (VB)
unnamed: C11.1, R21.2, R22.2, R23.1
unnamed: C12.1, R20.2, R24.1, R25.1
unnamed: C14.1, Q1.1 (B), Q4.3 (C), R14.2
unnamed: D2.1 (K), D3.1 (K), R25.2, R26.1
unnamed: Q1.3 (C), R10.1, U2.10 (SD)
unnamed: Q2.1 (B), R18.1, R19.1
unnamed: Q3.2 (B), R17.1, R27.2
unnamed: Q3.3 (C), R16.1
unnamed: Q4.1 (B), R16.2, R28.1
unnamed: R1.2, R2.1
unnamed: R2.2, R3.1
unnamed: R3.2, R4.1, R5.2
unnamed: R5.1, U1.5 (+)
unnamed: R6.2, R7.1, R8.2
unnamed: R8.1, U1.6 (_)
unnamed: R9.1, R10.2
unnamed: R11.2, U2.3 (SYNC)
unnamed: R12.2, U2.6 (RT)
unnamed: R15.1, U2.7 (DISCH)
unnamed: R20.1, U1.3 (+)
unnamed: R21.1, U1.2 (-)
unnamed: U2.11 (OUTA), U3.10 (HIN)
unnamed: U2.14 (OUTB), U3.12 (LIN)
ShutDown: J1.10, R19.2
VB+: J1.1, R1.1
Vs: C8.2, C10.2, J1.4, U3.5 (VS)
~ShutDown: J1.13, Q2.3 (C), R13.2, R17.2, U1.1, U1.7

Notes on the sheet:
2,782V Schwelle 12,9 A
0.215V/A
fs=286kHz
0,275V/A
Design Consideration Max Current 10A Current Transformer 1:100 Vr=10A/80 * Rs bei Rs = 22 Vr = 2.2V

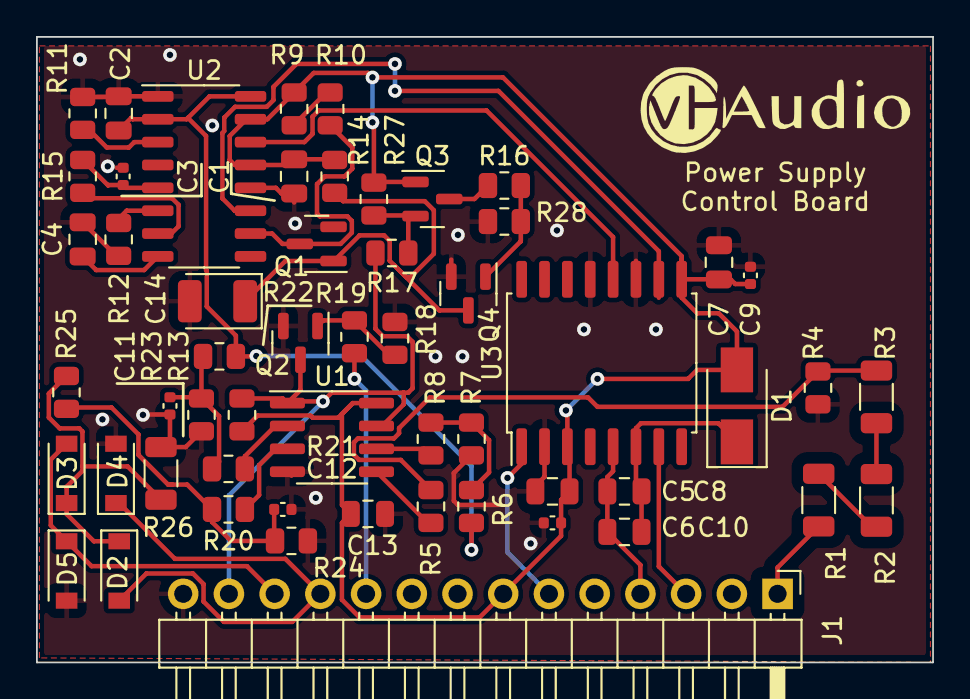
[picture p12: board Power Supply Control Board SG3525.kicad_pcb from above]

Board: 2 copper layers, 49.8 x 34.8 mm, 55 parts (0 on the bottom side), 37 nets.
