dvh61/AudioPowerSupplyV2.0/(commit log)

2021-03-29 Start of with basic Version
    [Audio Power Supply Board v3.0.kicad_pcb, Audio Power Supply Board v3.0.kicad_sch, Aux.kicad_sch, Auxiliary Supply.kicad_pcb, Auxiliary Supply.kicad_sch, Auxiliary Supply.sch, Controller.kicad_sch, FanCtrl.kicad_sch]
2021-03-29 Version with transformer Aux
    [Power Supply Board v2.0.kicad_pcb]
2021-03-30 Change to a modular drawing and design
    [Audio Power Supply Board v3.0.kicad_sch, Aux.kicad_sch, Controller.kicad_sch, FanCtrl.kicad_sch, Mute.kicad_sch, Power.kicad_sch, Primaryprot.kicad_sch, Secondary Power.kicad_sch]
2021-03-31 Add protection circuits
    [Audio Power Supply Board v3.0.kicad_sch, FanCtrl.kicad_sch, Power.kicad_sch, Primaryprot.kicad_sch, Protection.kicad_sch, Secondary Power.kicad_sch, inrush.kicad_sch, ledcontrol.kicad_sch]
2021-04-09 Finish design of SG3525 Board into SMD
    [Auxiliary Supply.kicad_pcb, Auxiliary Supply.kicad_sch, Power Supply Control Board SG3525 BOM.xlsx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]
2021-04-09 Add Top Layer Zones and some graphics to Main Board V2.0
    [Power Supply Board v2.0-B_Cu_.gbr, Power Supply Board v2.0-B_Mask.gbr, Power Supply Board v2.0-B_Paste.gbr, Power Supply Board v2.0-B_Silkscreen.gbr, Power Supply Board v2.0-Edge_Cuts.gbr, Power Supply Board v2.0-F_Cu.gbr, Power Supply Board v2.0-F_Mask.gbr, Power Supply Board v2.0-F_Paste.gbr]
2021-04-14 Add stitching and move some components around, so taht they no longer are top of each other
    [Power Supply Board v2.0-B_Cu_.gbr, Power Supply Board v2.0-B_Mask.gbr, Power Supply Board v2.0-B_Paste.gbr, Power Supply Board v2.0-B_Silkscreen.gbr, Power Supply Board v2.0-Edge_Cuts.gbr, Power Supply Board v2.0-F_Cu.gbr, Power Supply Board v2.0-F_Mask.gbr, Power Supply Board v2.0-F_Paste.gbr]
2021-04-23 Cleanup of current status for V3.0
    [Auxiliary Supply.kicad_pcb, Auxiliary Supply.kicad_sch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]
